jimearruti/latent_gloves/images/conductive_thread_gnd.jpg

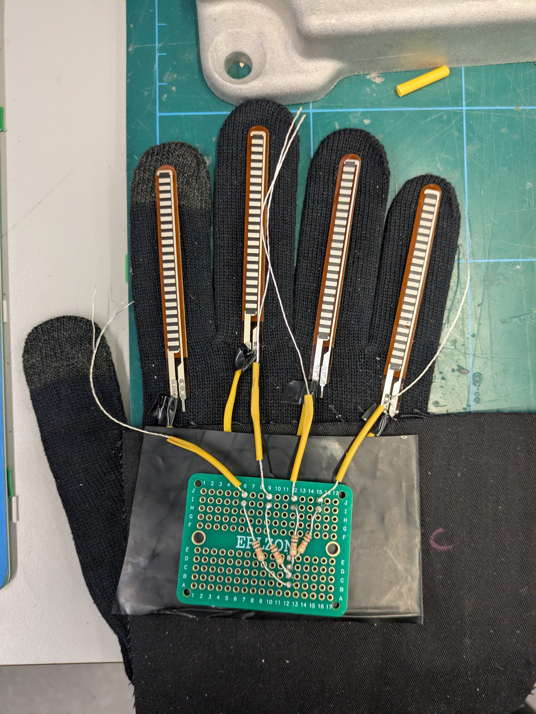
images/conductive_thread_gnd.jpg
