jimearruti/latent_gloves/images/schematic_MPU6050.png

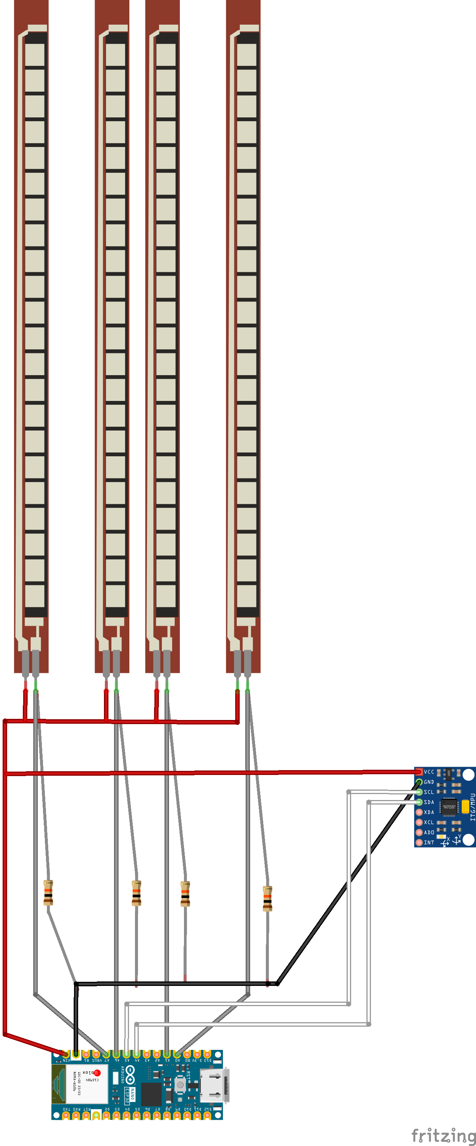
images/schematic_MPU6050.png
