jimearruti/latent_gloves/images/schematic_resistors.png

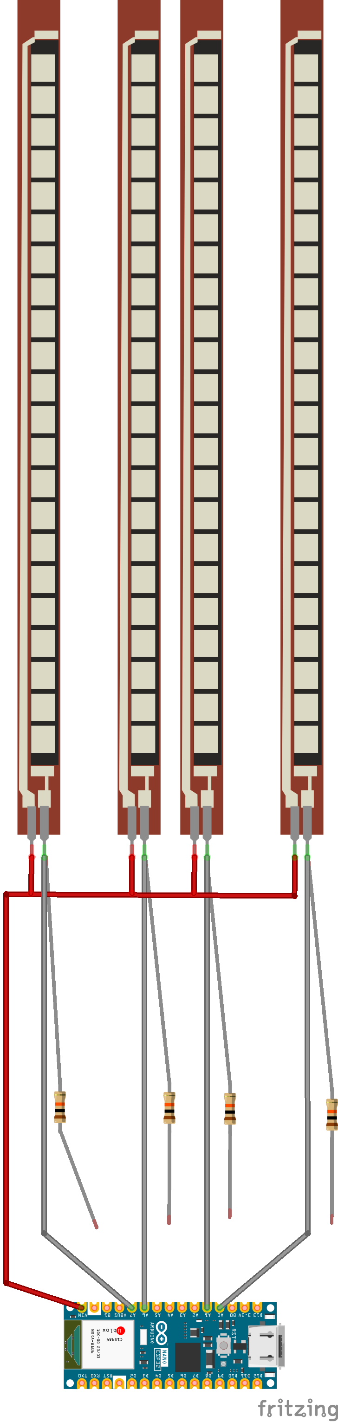
images/schematic_resistors.png
