jimearruti/latent_gloves/(commit log)

2025-12-15 Add Arduino files
2026-02-02 Revise glove building guide and improve formatting
    Updated the materials list and building instructions for clarity. Improved formatting for images and added notes on testing connections.
2026-02-02 Add image for cabled version in README
2026-02-02 Add MPU 6050 module to glove building materials
    Added MPU 6050 module to the list of required materials for building the glove.
2026-02-07 Revise instructions for building Latent Glove
    Updated the guide to build the Latent Glove, including changes to materials, instructions for both cabled and conductive thread versions, and improved clarity in the steps.
2026-02-07 add schematic MPU6050 image
2026-02-09 Update acknowledgment for Kalman filter code
2026-02-09 Add reference to Kalman filter source in code
    Added a comment referencing the Kalman filter implementation source.
2026-02-09 Remove cabled version image from README
    Remove image of cabled version from README.
2026-02-09 Update calibration instructions in README
    Clarified instructions for running the code and checking calibration.
2026-06-23 update after Sonar Hacklab performance
